BleuLlama/LL530/Firmware/Reference/README.md

# NOTE:

The files contained in here DO NOT carry the MIT License that the
rest of this project uses. These were copied from the Arduino.cc
forums, specifically from [the thread about the Amiga keyboard
interface](http://forum.arduino.cc/index.php?topic=139358.75).

These are assumed to be in the public domain, and are distributed
here relatively as-posted.
