BleuLlama/LL530/Firmware/Reference/Keyboard_002_Steve_Reaver/notes.txt

US QWERTY layout
Printscreen functionality
