BleuLlama/LL530/Firmware/Reference/CD32/CD32toUSB/CD32-USB-Arduino.png

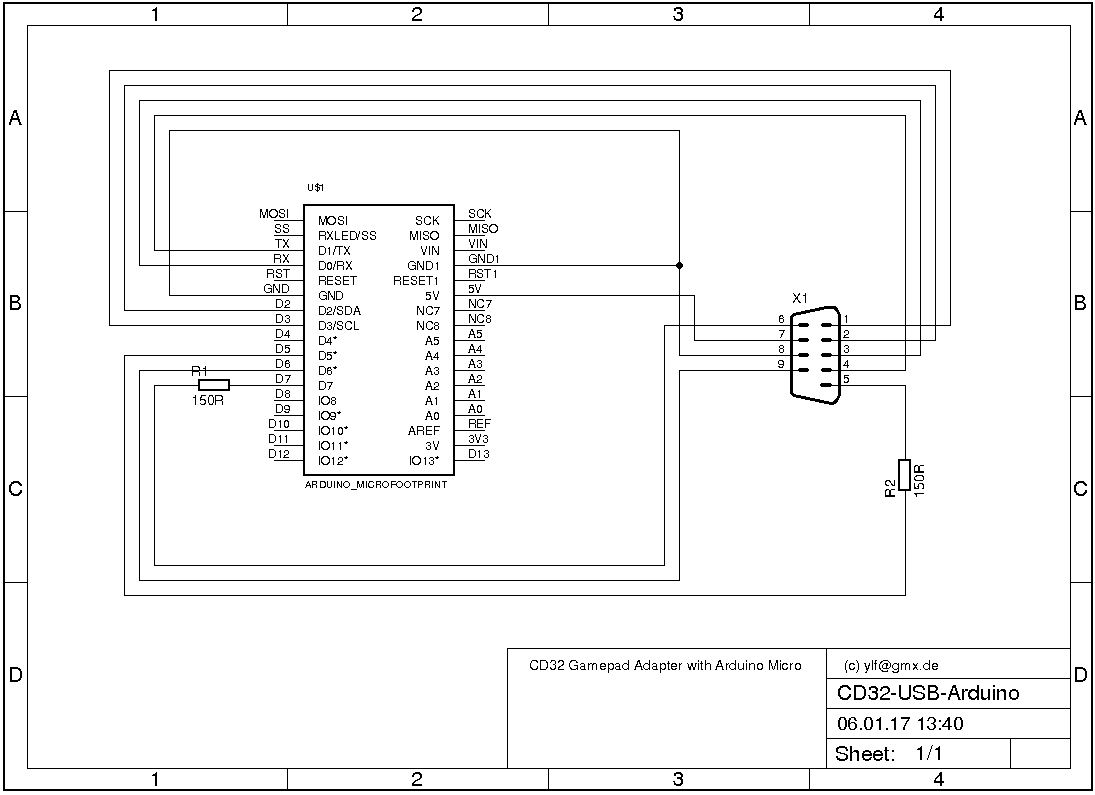
Firmware/Reference/CD32/CD32toUSB/CD32-USB-Arduino.png
