BleuLlama/LL530/Hardware/Schematic_V100.pdf

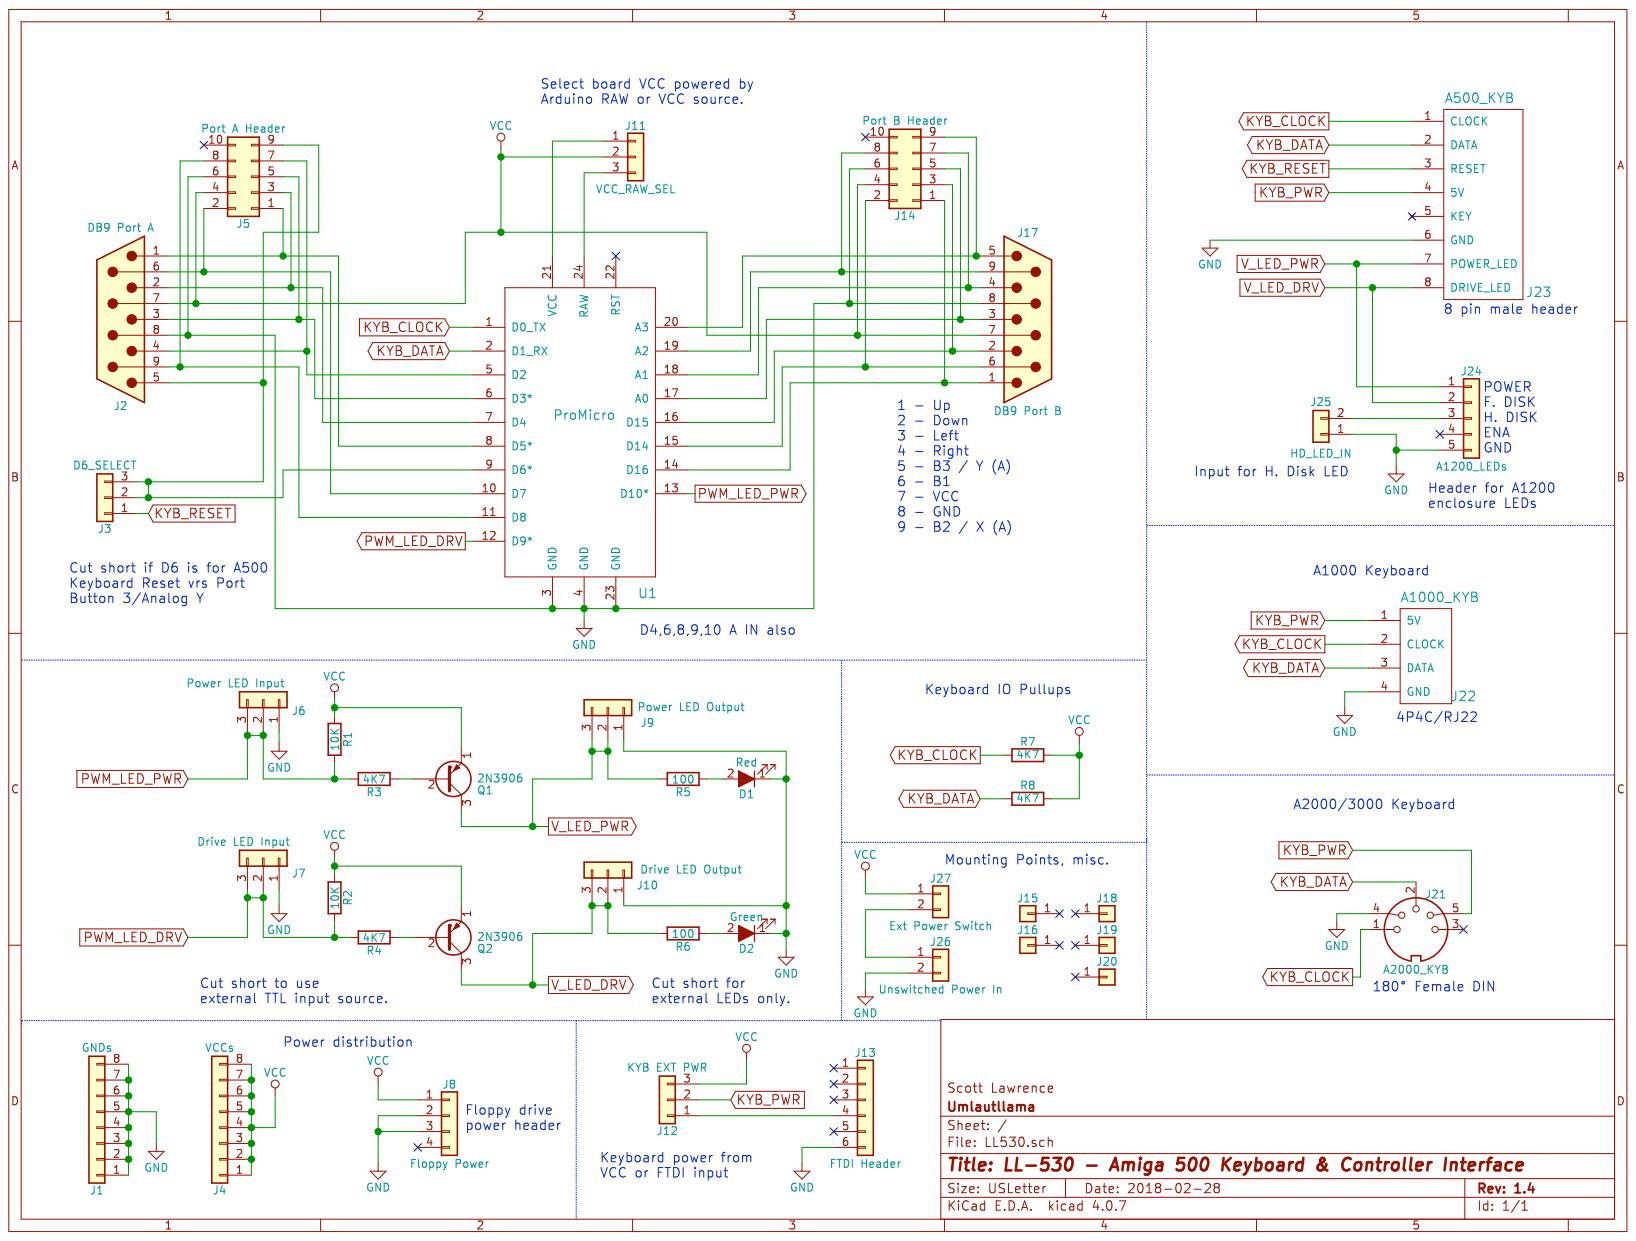
[picture p2: page 1]
