BleuLlama/LL530/(commit log)

2018-07-02 Various projects copied from the Arduino forums
2019-12-02 Updates to allow builds without device connected.
2019-12-07 Keyboard + Joystick + Mouse. (Mouse read in timer thread)
2019-12-17 Added version 1 schematics and notes
2019-12-18 Port device etc switching almost done! (Interim checkin)
2020-01-06 LED support from the serial interface now. ISR is conflicting with port routine
2020-03-04 Fixed mouse disappearing and being sluggish
    [LL530_Keyboard_AB_v1.ino, Ports.ino, Settings.ino]
